dsalaj/cybr_light_blade/light_blade/pcbway_production/2026-10-18-12-11-58/light_blade_BOM_PCBWay.xlsx

 |  |  | Light Blade v1 - BOM Rev 3 (2026-10-18), quantities per 1 board
Item # | *Designator | *Qty | Manufacturer | *Mfg Part # | Description / Value | *Package/Footprint | Type | Your Instructions / Notes
1 | C1,C2,C3,C4,C5,C6,C7,C8,C9,C10 | 10 | Samsung Electro-Mechanics | CL21B104KBCNNNC | CAP CER 100nF 50V X7R ±10% 0805 | 0805 | SMD | LCSC C1711
2 | C11 | 1 | Panasonic | EEE-FK1A471P | CAP ALU ELEC 470uF 10V ±20% 105°C, FK series, 0.16 Ohm, 600mA ripple | SMD radial can 8x10.2mm (D x H), height 10.2mm | SMD | Polarized - observe + marking. Alt: EEEFK1A471AP (LCSC C178529)
3 | D1,D2,D3,D4,D5,D6,D7,D8,D9,D10,D17,D18 | 12 | Hubei KENTO Elec | KT-0805W | LED WHITE 0805, Vf 2.6-3.2V, 350mcd @ 25mA, 120° | 0805 | SMD | LCSC C34499. Polarized - cathode per footprint marking
4 | J1,J2 | 2 | JST | S3B-XH-A(LF)(SN) | CONN HEADER XH 3POS SHROUDED RIGHT ANGLE (SIDE ENTRY) 3A 250V | THT 1x3, 2.5mm lead pitch, height 9.8mm | thru-hole | LCSC C157928
5 | R1,R2,R3,R4,R5,R6,R7,R8,R9,R10,R21 | 11 | YAGEO | RC0805FR-0733RL | RES 33 OHM ±1% 1/8W (0.125W) THICK FILM 0805 | 0805 | SMD
6 | R11,R12,R13,R14,R15,R16,R17,R18,R19,R20 | 10 | YAGEO | RC0805FR-07100RL | RES 100 OHM ±1% 1/8W (0.125W) THICK FILM 0805 | 0805 | SMD
7 | U1,U2,U3,U4,U5,U6,U7,U8,U9,U10 | 10 | Worldsemi | WS2811 | IC LED DRIVER 3CH CONSTANT CURRENT 18.5mA, WS281x 1-WIRE, 5V | SOIC-8 (mfr code SOP-8), 3.9x4.9mm, 1.27mm pitch | SMD | LCSC C114581. Pin 1 per silkscreen marker
