dsalaj/cybr_light_blade/light_blade/light_blade.kicad_pcb

## KiCad design light_blade/light_blade.kicad_pcb (2026-10-18)

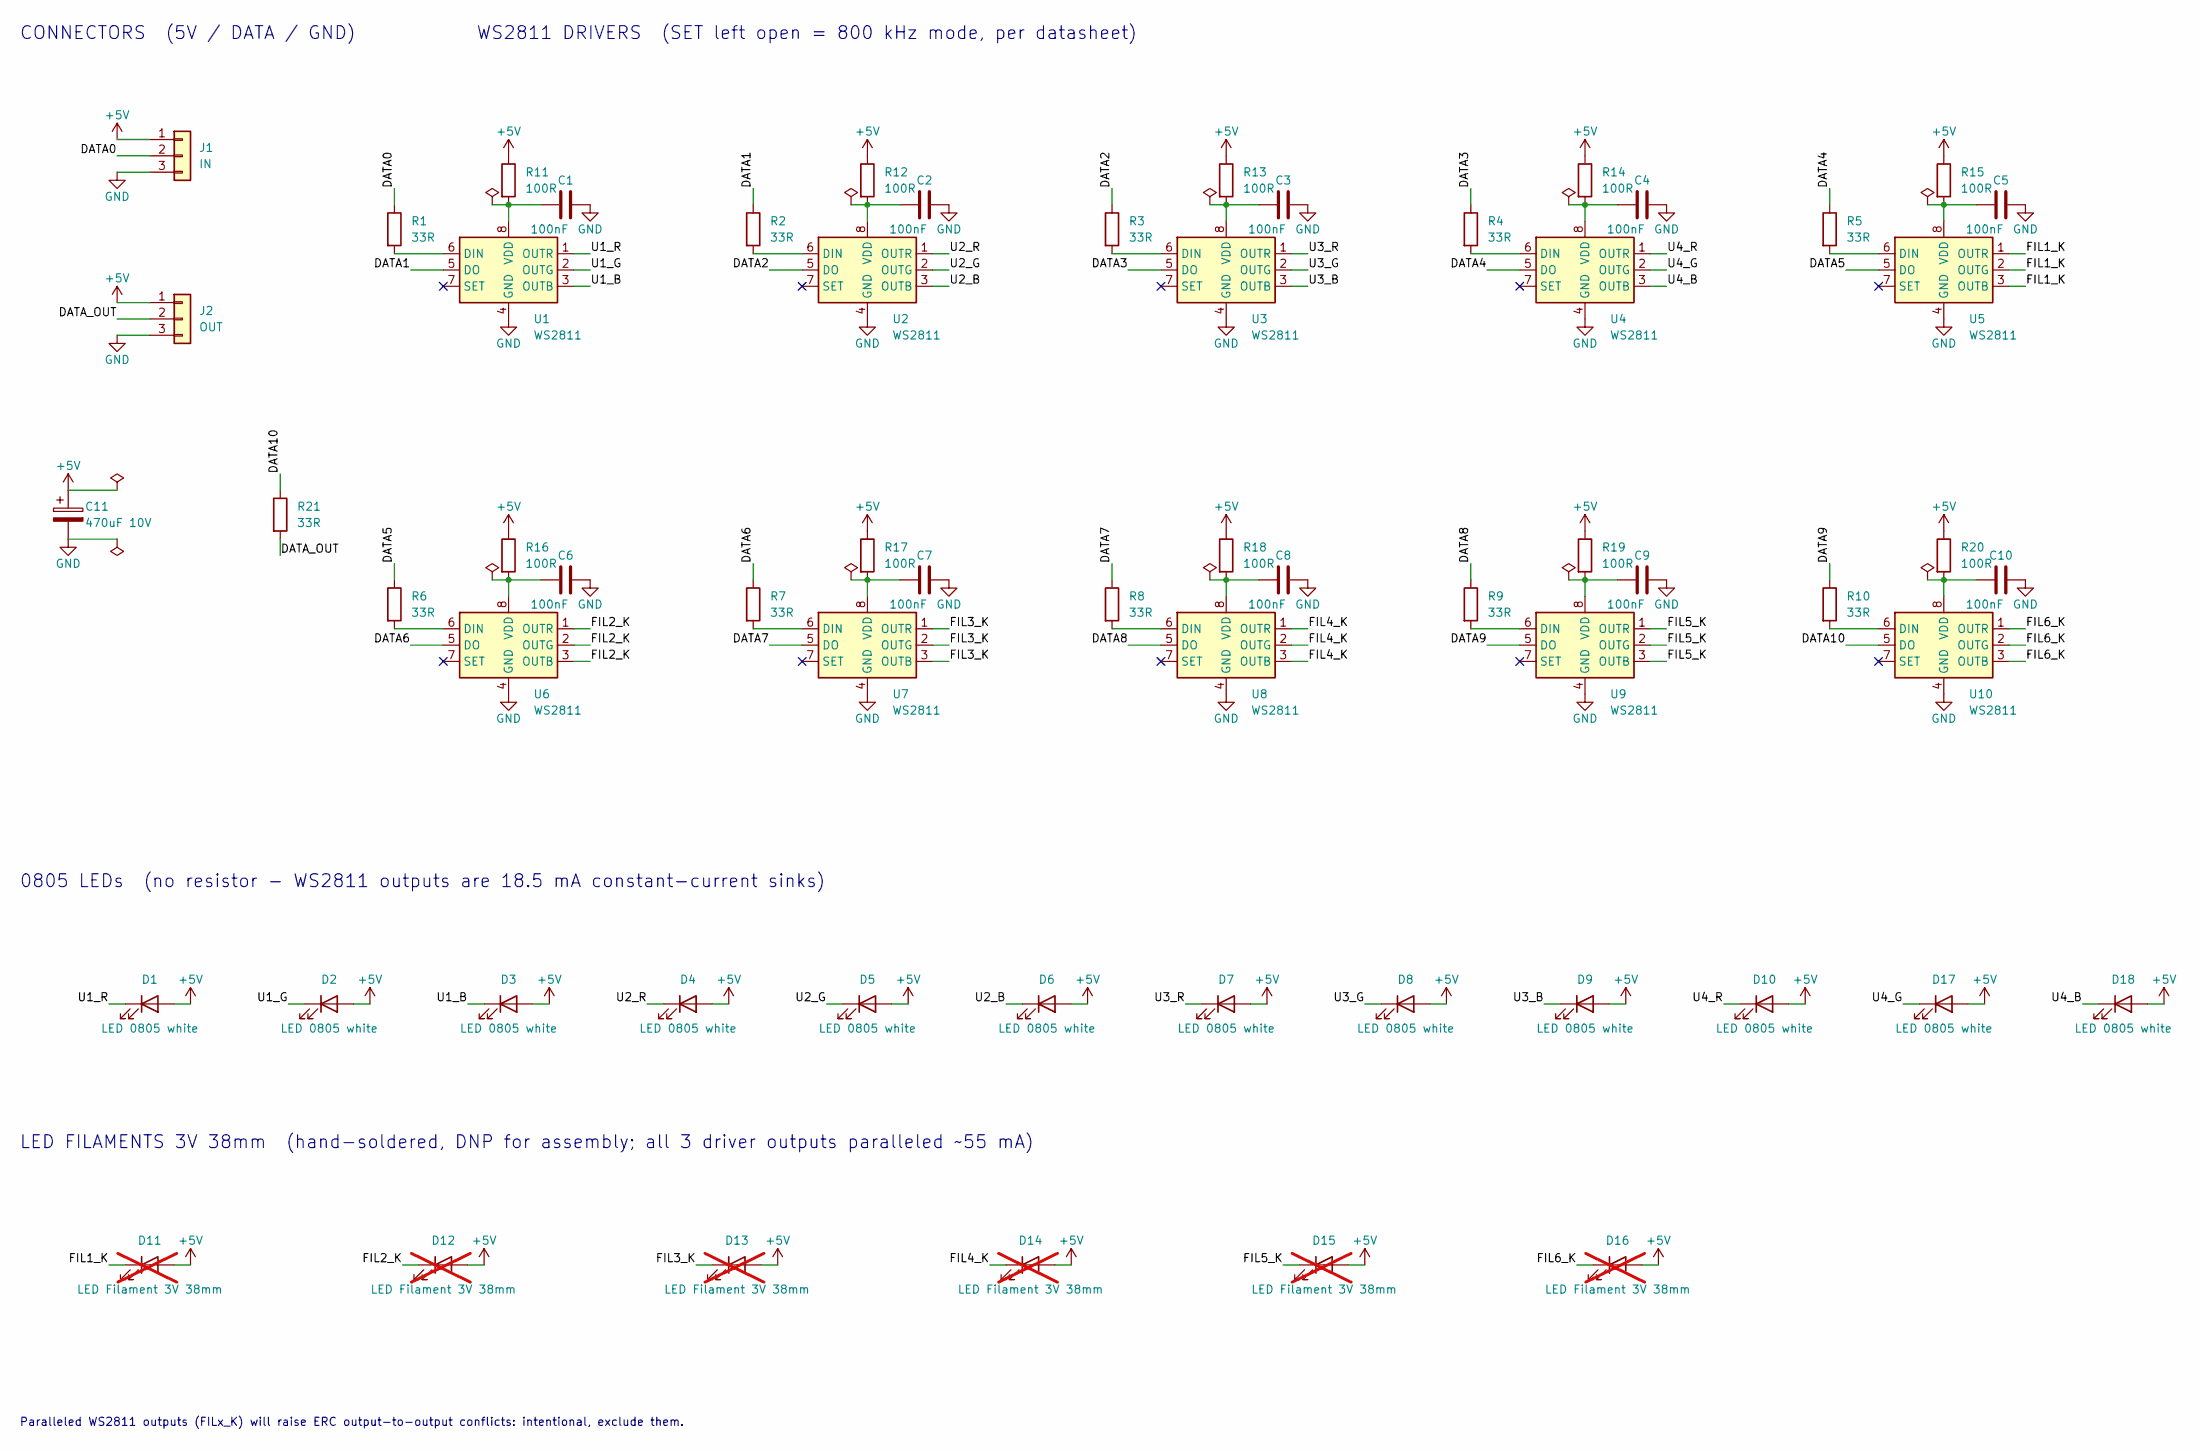
[picture p4: schematic light_blade.kicad_sch, Light Blade - WS2811 LED board]

Parts:
C1, C2, C3, C4, C5, C6, C7, C8, C9, C10: 100nF; C_0805_2012Metric
C11: 470uF 10V; CP_Elec_8x10
D1, D2, D3, D4, D5, D6, D7, D8, D9, D10, D17, D18: LED 0805 white; LED_0805_2012Metric
D11, D12, D13, D14, D15, D16: LED Filament 3V 38mm; LED_Filament_38mm; not fitted
J1: IN; JST_XH_S3B-XH-A_1x03_P2.50mm_Horizontal; MPN S3B-XH-A (or XH-3AW clone)
J2: OUT; JST_XH_S3B-XH-A_1x03_P2.50mm_Horizontal; MPN S3B-XH-A (or XH-3AW clone)
R1, R2, R3, R4, R5, R6, R7, R8, R9, R10, R21: 33R; R_0805_2012Metric
R11, R12, R13, R14, R15, R16, R17, R18, R19, R20: 100R; R_0805_2012Metric
U1, U2, U3, U4, U5, U6, U7, U8, U9, U10: WS2811; SOIC-8_3.9x4.9mm_P1.27mm

Connections:
+5V: C11.1, D1.2 (A), D2.2 (A), D3.2 (A), D4.2 (A), D5.2 (A), D6.2 (A), D7.2 (A), D8.2 (A), D9.2 (A), D10.2 (A), D11.2 (A), D12.2 (A), D13.2 (A), D14.2 (A), D15.2 (A), D16.2 (A), D17.2 (A), D18.2 (A), J1.1, J2.1, R11.1, R12.1, R13.1, R14.1, R15.1, R16.1, R17.1, R18.1, R19.1, R20.1
/DATA0: J1.2, R1.1
/DATA1: R2.1, U1.5 (DO)
/DATA2: R3.1, U2.5 (DO)
/DATA3: R4.1, U3.5 (DO)
/DATA4: R5.1, U4.5 (DO)
/DATA5: R6.1, U5.5 (DO)
/DATA6: R7.1, U6.5 (DO)
/DATA7: R8.1, U7.5 (DO)
/DATA8: R9.1, U8.5 (DO)
/DATA9: R10.1, U9.5 (DO)
/DATA10: R21.1, U10.5 (DO)
/DATA_OUT: J2.2, R21.2
/FIL1_K: D11.1 (K), U5.1 (OUTR), U5.2 (OUTG), U5.3 (OUTB)
/FIL2_K: D12.1 (K), U6.1 (OUTR), U6.2 (OUTG), U6.3 (OUTB)
/FIL3_K: D13.1 (K), U7.1 (OUTR), U7.2 (OUTG), U7.3 (OUTB)
/FIL4_K: D14.1 (K), U8.1 (OUTR), U8.2 (OUTG), U8.3 (OUTB)
/FIL5_K: D15.1 (K), U9.1 (OUTR), U9.2 (OUTG), U9.3 (OUTB)
/FIL6_K: D16.1 (K), U10.1 (OUTR), U10.2 (OUTG), U10.3 (OUTB)
/U1_B: D3.1 (K), U1.3 (OUTB)
/U1_G: D2.1 (K), U1.2 (OUTG)
/U1_R: D1.1 (K), U1.1 (OUTR)
/U2_B: D6.1 (K), U2.3 (OUTB)
/U2_G: D5.1 (K), U2.2 (OUTG)
/U2_R: D4.1 (K), U2.1 (OUTR)
/U3_B: D9.1 (K), U3.3 (OUTB)
/U3_G: D8.1 (K), U3.2 (OUTG)
/U3_R: D7.1 (K), U3.1 (OUTR)
/U4_B: D18.1 (K), U4.3 (OUTB)
/U4_G: D17.1 (K), U4.2 (OUTG)
/U4_R: D10.1 (K), U4.1 (OUTR)
GND: C1.2, C2.2, C3.2, C4.2, C5.2, C6.2, C7.2, C8.2, C9.2, C10.2, C11.2, J1.3, J2.3, U1.4 (GND), U2.4 (GND), U3.4 (GND), U4.4 (GND), U5.4 (GND), U6.4 (GND), U7.4 (GND), U8.4 (GND), U9.4 (GND), U10.4 (GND)
unnamed: R1.2, U1.6 (DIN)
unnamed: C1.1, R11.2, U1.8 (VDD)
unnamed: R2.2, U2.6 (DIN)
unnamed: C2.1, R12.2, U2.8 (VDD)
unnamed: R3.2, U3.6 (DIN)
unnamed: C3.1, R13.2, U3.8 (VDD)
unnamed: R4.2, U4.6 (DIN)
unnamed: C4.1, R14.2, U4.8 (VDD)
unnamed: R5.2, U5.6 (DIN)
unnamed: C5.1, R15.2, U5.8 (VDD)
unnamed: R6.2, U6.6 (DIN)
unnamed: C6.1, R16.2, U6.8 (VDD)
unnamed: R7.2, U7.6 (DIN)
unnamed: C7.1, R17.2, U7.8 (VDD)
unnamed: R8.2, U8.6 (DIN)
unnamed: C8.1, R18.2, U8.8 (VDD)
unnamed: R9.2, U9.6 (DIN)
unnamed: C9.1, R19.2, U9.8 (VDD)
unnamed: R10.2, U10.6 (DIN)
unnamed: C10.1, R20.2, U10.8 (VDD)

Notes on the sheet:
CONNECTORS (5V / DATA / GND)
WS2811 DRIVERS (SET left open = 800 kHz mode, per datasheet)
0805 LEDs (no resistor - WS2811 outputs are 18.5 mA constant-current sinks)
LED FILAMENTS 3V 38mm (hand-soldered, DNP for assembly; all 3 driver outputs paralleled ~55 mA)
Paralleled WS2811 outputs (FILx_K) will raise ERC output-to-output conflicts: intentional, exclude them.

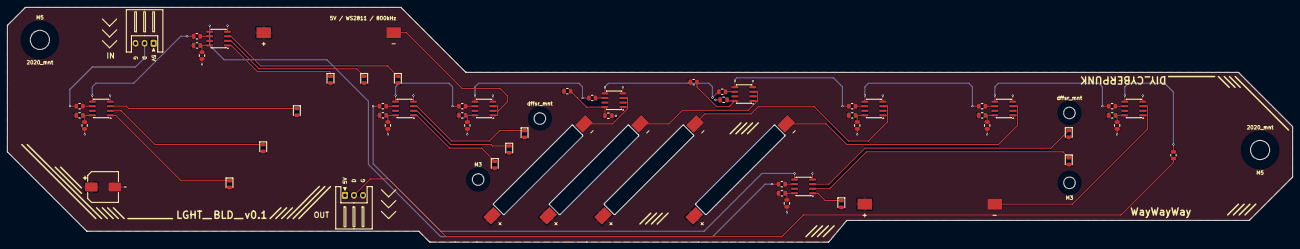
[picture p5: board light_blade.kicad_pcb from above]

Board: 2 copper layers, 356.0 x 65.0 mm, 68 parts (0 on the bottom side), 52 nets.

Other parts of the board:
2020_mnt, 2020_mnt#2: MountingHole_5.3mm_M5
M3, M3#2: MountingHole_3.2mm_M3
dffsr_mnt: MountingHole_3.2mm_M3
dffsr_mnt#2: MountingHole_3.2mm_M3
