dsalaj/cybr_light_blade/(commit log)

2026-10-18 Initial commit: Light Blade v1 KiCad project and PCBWay production files
    - KiCad 10 schematic, PCB layout and custom LED filament footprint
    - Fabrication gerbers and PCBWay export from 2026-10-15
    - BOM rev 2 for PCBWay: full manufacturer part numbers, unique
    designators (duplicate D10s renamed to D17/D18), filaments removed
    - Design plan and PCBWay sample BOM template
    [Sample_BOM_PCBWay.xlsx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]
2026-10-18 Rev 3: mounting-hole keepouts, decoupling fixes, D17/D18 in schematic
    - Add copper keepouts on both layers around all mounting holes
    (7 mm for M3, 11 mm for M5) so metal screws can't bridge +5V/GND
    - Move C6 and C7 next to the VDD pin of U6/U7 (was ~10 mm away);
    R7 moved back to its standard position to make room
    - Add D17/D18 to the schematic on U4_G/U4_B and link the PCB
    footprints, removing the U4 schematic/PCB net conflicts
    - Regenerate fab_gerber and a new PCBWay export (2026-10-18) with
    BOM Rev 3 and positions file
    - Update plan doc for U4 driving D10/D17/D18
    [light_blade-B_Cu.gbr, light_blade-B_Mask.gbr, light_blade-B_Paste.gbr, light_blade-B_Silkscreen.gbr, light_blade-Edge_Cuts.gbr, light_blade-F_Cu.gbr, light_blade-F_Mask.gbr, light_blade-F_Paste.gbr]
2026-10-18 Add cyberpunk README with board renders
